GabrielDaSilvaViana/ReservaDeSala-System1/InnovaRoom/image.png

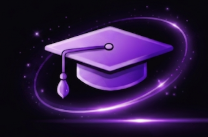
InnovaRoom/image.png
