GabrielDaSilvaViana/ReservaDeSala-System1/docs/esquema-3-solenoides.png

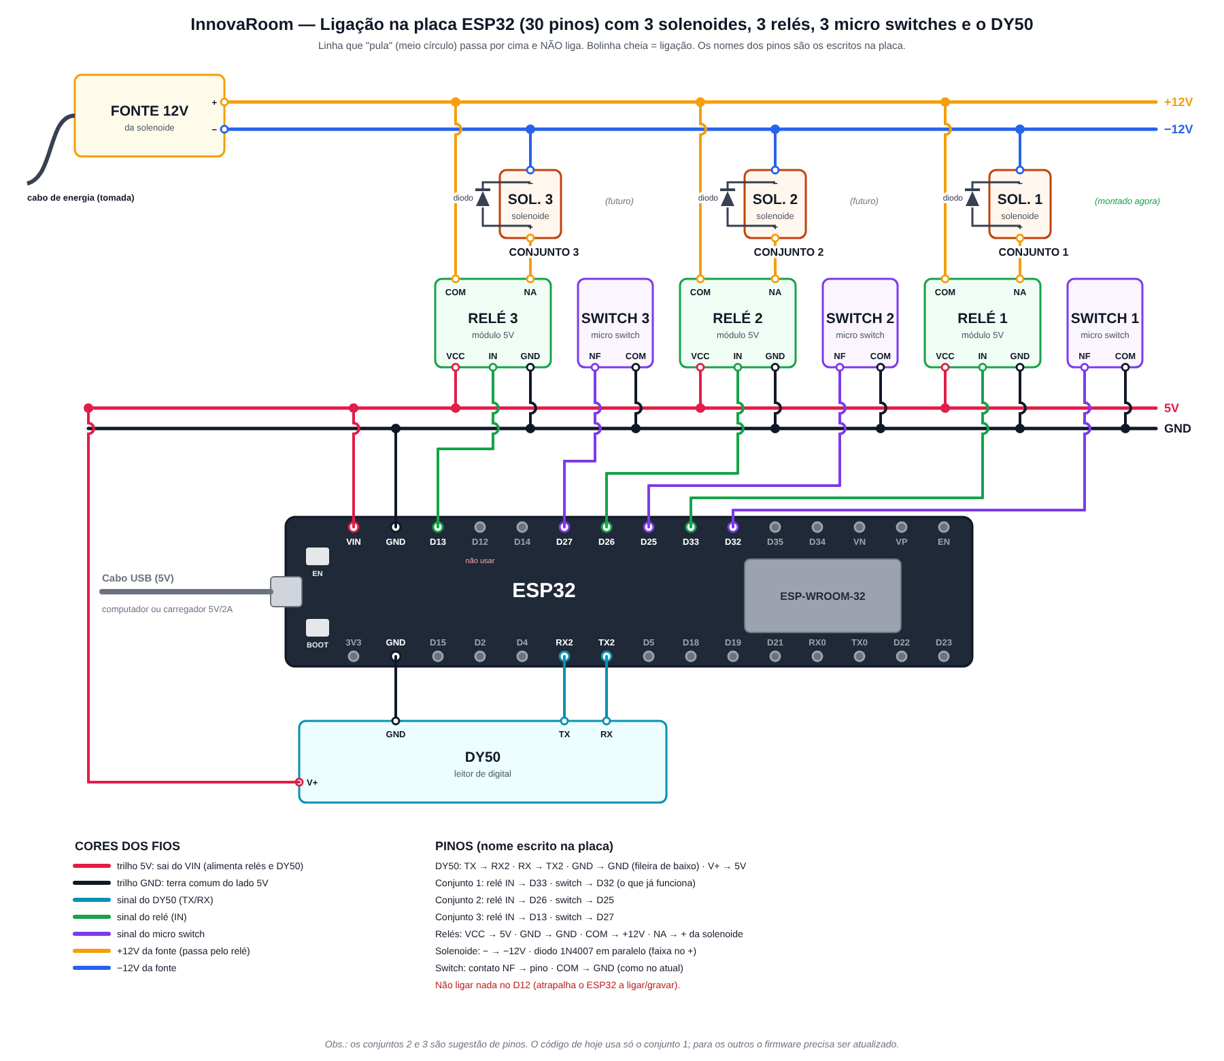
docs/esquema-3-solenoides.png
