GabrielDaSilvaViana/ReservaDeSala-System1/esp32/solenoid_arduino/secrets.example.h

// Copie este arquivo para "secrets.h" (na mesma pasta) e preencha.
// O secrets.h NÃO deve ir para o GitHub (já está no .gitignore).
#pragma once

#define WIFI_SSID     "NOME_DA_REDE"
#define WIFI_PASSWORD "SENHA_DA_REDE"

// Mesmo valor de ESP32_TOKEN no arquivo .env do servidor.
// Deixe "" para desativar a verificação (não recomendado).
#define ESP32_TOKEN   ""
