GabrielDaSilvaViana/ReservaDeSala-System1/(commit log)

2026-10-05 alteração e adicionado novas coisas
    [MICRO_SWITCH_CONFIG.txt]
2026-10-19 Devolucao da chave por QR code e sala volta para reservada
2026-10-26 Preparado para 3 solenoides, botoes da sala em grade e Font Awesome local
    - Firmware do ESP32 com 3 solenoides (solenoide 1 com os mesmos pinos)
    - Salas do 1o andar divididas por fileira: solenoide 1, 2 e 3
    - Devolucao por QR code com os 3 QR codes
    - Janela da sala com os botoes em grade e o Fechar embaixo
    - Font Awesome dentro do projeto (icones funcionam sem internet)
    - Esquema de ligacao das 3 solenoides em docs/
2026-10-26 Landing page do TCC no GitHub Pages (pasta docs)
    - docs/index.html: landing page do InnovaRoom com a logo do capelo
    - docs/.nojekyll para o GitHub Pages servir os arquivos como estao
    - Link do site no README
2026-11-12 Fotos da equipe na landing page (pasta docs/img/equipe ou foto do GitHub)
